JLtech59/Light_Saber_Ready_Combat/README.md

# Light_Saber_Ready_Combat
Stuff usefull if you want to recreate a light saber with arduino
